hiramrodriguez14/Turbine_MCU/report.txt

Plotted to '/Users/hiramraul11gmail.com/Micro 2/TurbineMCUJST/gerbers/TurbineMCU-F_Cu.gtl'.
Plotted to '/Users/hiramraul11gmail.com/Micro 2/TurbineMCUJST/gerbers/TurbineMCU-In1_Cu.g1'.
Plotted to '/Users/hiramraul11gmail.com/Micro 2/TurbineMCUJST/gerbers/TurbineMCU-In2_Cu.g2'.
Plotted to '/Users/hiramraul11gmail.com/Micro 2/TurbineMCUJST/gerbers/TurbineMCU-B_Cu.gbl'.
Plotted to '/Users/hiramraul11gmail.com/Micro 2/TurbineMCUJST/gerbers/TurbineMCU-F_Paste.gtp'.
Plotted to '/Users/hiramraul11gmail.com/Micro 2/TurbineMCUJST/gerbers/TurbineMCU-B_Paste.gbp'.
Plotted to '/Users/hiramraul11gmail.com/Micro 2/TurbineMCUJST/gerbers/TurbineMCU-F_Silkscreen.gto'.
Plotted to '/Users/hiramraul11gmail.com/Micro 2/TurbineMCUJST/gerbers/TurbineMCU-B_Silkscreen.gbo'.
Plotted to '/Users/hiramraul11gmail.com/Micro 2/TurbineMCUJST/gerbers/TurbineMCU-F_Mask.gts'.
Plotted to '/Users/hiramraul11gmail.com/Micro 2/TurbineMCUJST/gerbers/TurbineMCU-B_Mask.gbs'.
Plotted to '/Users/hiramraul11gmail.com/Micro 2/TurbineMCUJST/gerbers/TurbineMCU-Edge_Cuts.gm1'.
Info: Done.
Info: Done.
