hiramrodriguez14/Turbine_MCU/mylib/DIP8.STEP

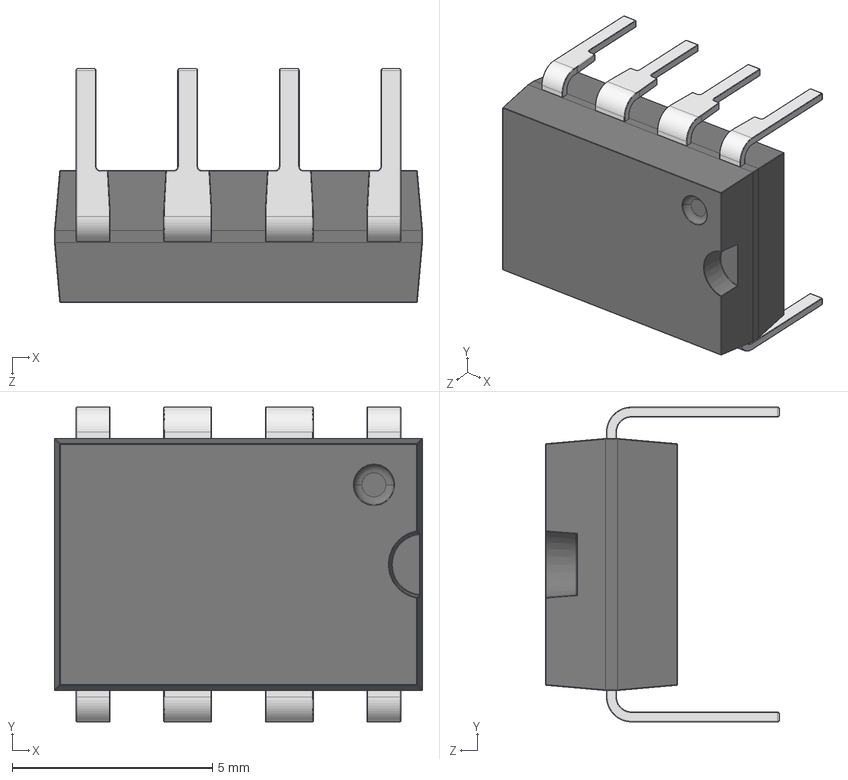
[picture p6: CAD file, 2026-04-30]
mylib/DIP8.STEP
9.20 x 7.87 x 5.85 mm
