hiramrodriguez14/Turbine_MCU/mylib/JST_3D/JST-XH7-SMD.step

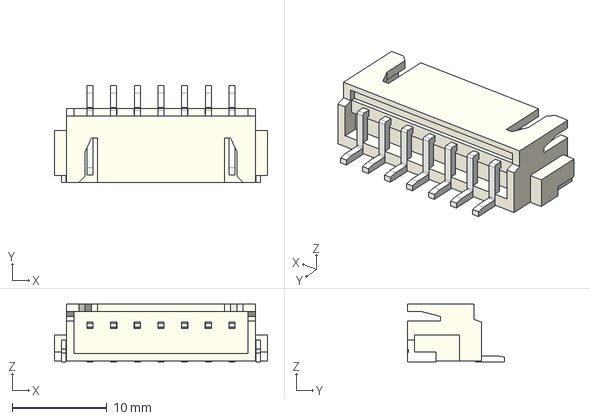
[picture p7: CAD file, 2026-04-30]
mylib/JST_3D/JST-XH7-SMD.step
22.5 x 10.2 x 6.10 mm
