hiramrodriguez14/Turbine_MCU/mylib/LIB_MCP41HV51-103E_ST/MCP41HV51-103E_ST/3D/MCP41HV51-103E_ST.stp

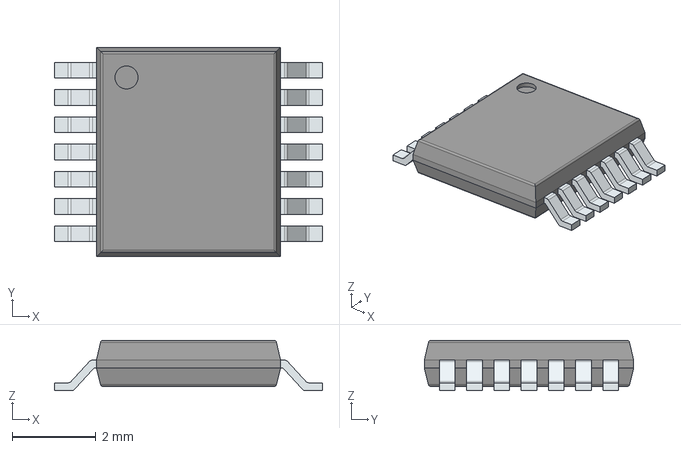
[picture p8: CAD file, 2026-04-30]
mylib/LIB_MCP41HV51-103E_ST/MCP41HV51-103E_ST/3D/MCP41HV51-103E_ST.stp
6.40 x 5.00 x 1.20 mm
PinsArrayLR
