hiramrodriguez14/Turbine_MCU/mylib/LIB_MSPM0G3507SPMR/MSPM0G3507SPMR/3D/MSPM0G3507SPMR.stp

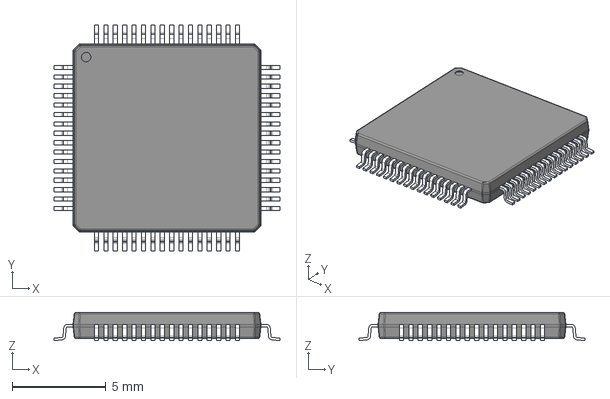
[picture p10: CAD file, 2026-04-30]
mylib/LIB_MSPM0G3507SPMR/MSPM0G3507SPMR/3D/MSPM0G3507SPMR.stp
12.0 x 12.0 x 1.50 mm
BODY-QFP
LEAD-QFP x 64
