hiramrodriguez14/Turbine_MCU/mylib/LIB_TC4429CPA/TC4429CPA/3D/TC4429CPA.stp

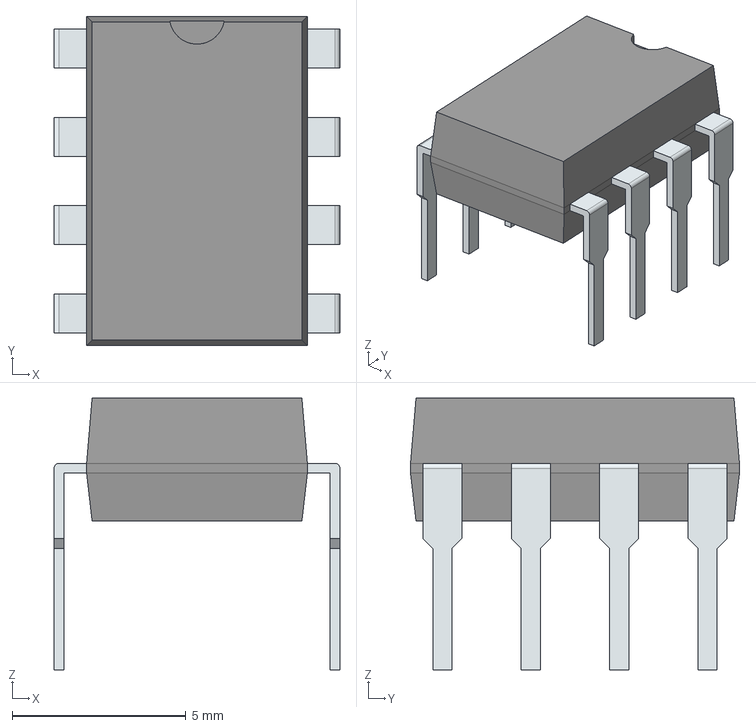
[picture p11: CAD file, 2026-04-30]
mylib/LIB_TC4429CPA/TC4429CPA/3D/TC4429CPA.stp
8.22 x 9.46 x 7.82 mm
PinsArrayLR
