hiramrodriguez14/Turbine_MCU/mylib/LIB_TPS2121RUXR/TPS2121RUXR/3D/TPS2121RUXR.stp

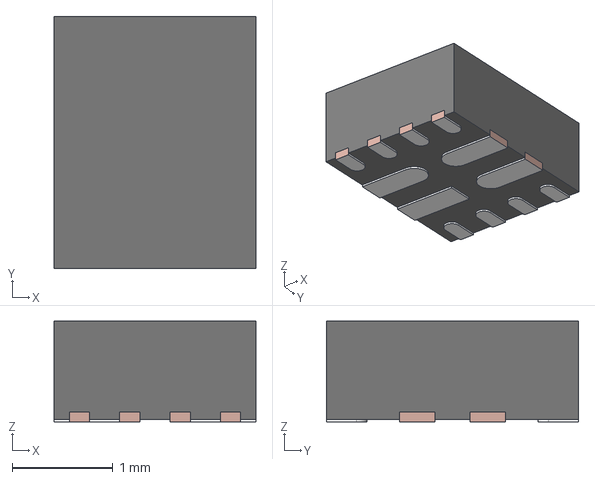
[picture p12: CAD file, 2026-04-30]
mylib/LIB_TPS2121RUXR/TPS2121RUXR/3D/TPS2121RUXR.stp
2.00 x 2.50 x 1.00 mm
FRAME
MOLD
