hiramrodriguez14/Turbine_MCU/mylib/JST_3D/JST-XH2-SMD.step

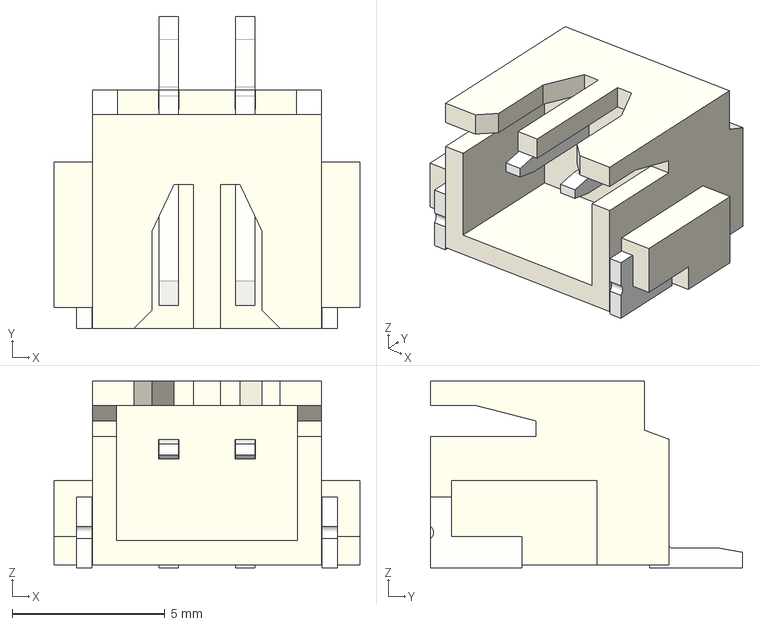
[picture p13: CAD file, 2026-04-30]
mylib/JST_3D/JST-XH2-SMD.step
10.0 x 10.2 x 6.10 mm
