hiramrodriguez14/Turbine_MCU/mylib/SW_Btn_XLX.step

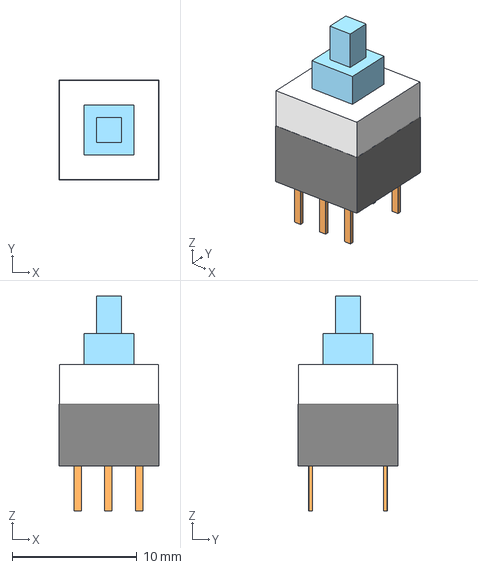
[picture p14: CAD file, 2026-04-30]
mylib/SW_Btn_XLX.step
8.00 x 8.00 x 17.2 mm
