hiramrodriguez14/Turbine_MCU/mylib/DIL14.stp

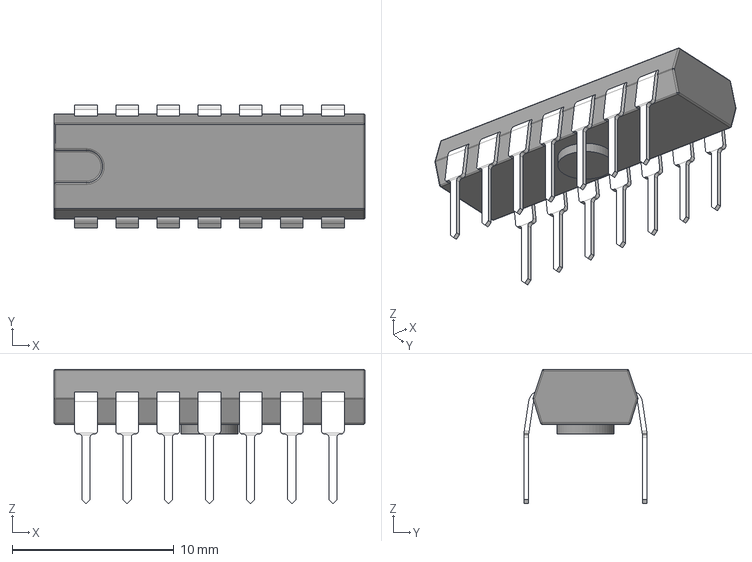
[picture p15: CAD file, 2026-04-30]
mylib/DIL14.stp
19.2 x 7.62 x 8.30 mm
DIP14_body
legs x 7
