hiramrodriguez14/Turbine_MCU/mylib/JST_3D/JST-XH6-SMD.step

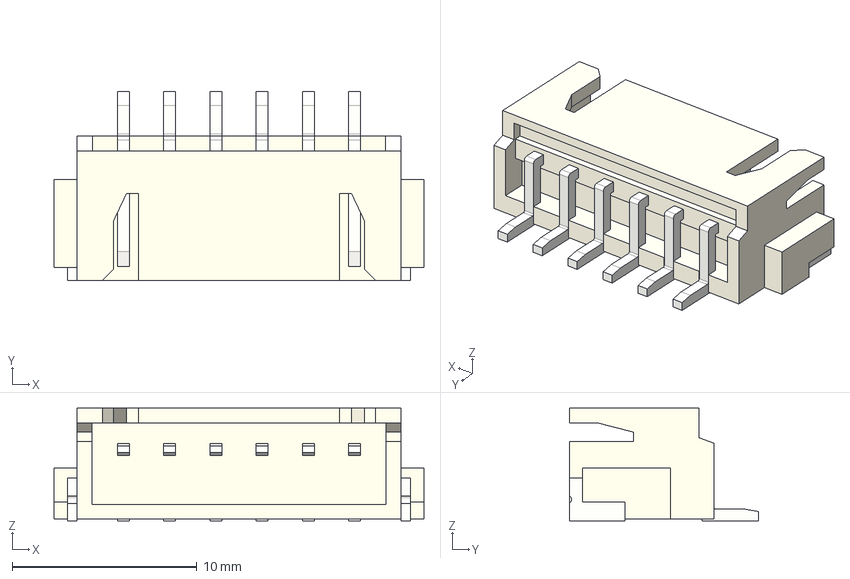
[picture p16: CAD file, 2026-04-30]
mylib/JST_3D/JST-XH6-SMD.step
20.0 x 10.2 x 6.10 mm
