hiramrodriguez14/Turbine_MCU/mylib/JST_3D/JST-XH5-SMD.step

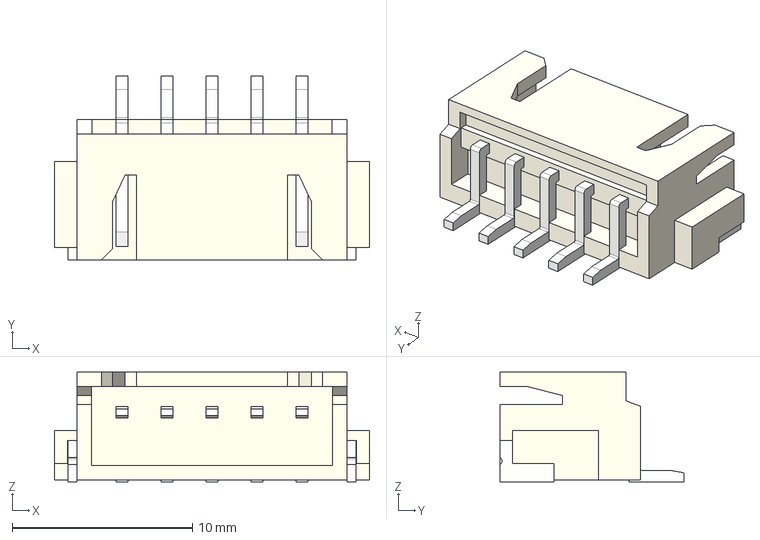
[picture p17: CAD file, 2026-04-30]
mylib/JST_3D/JST-XH5-SMD.step
17.5 x 10.2 x 6.10 mm
