hiramrodriguez14/Turbine_MCU/mylib/LQFP64 v1.step

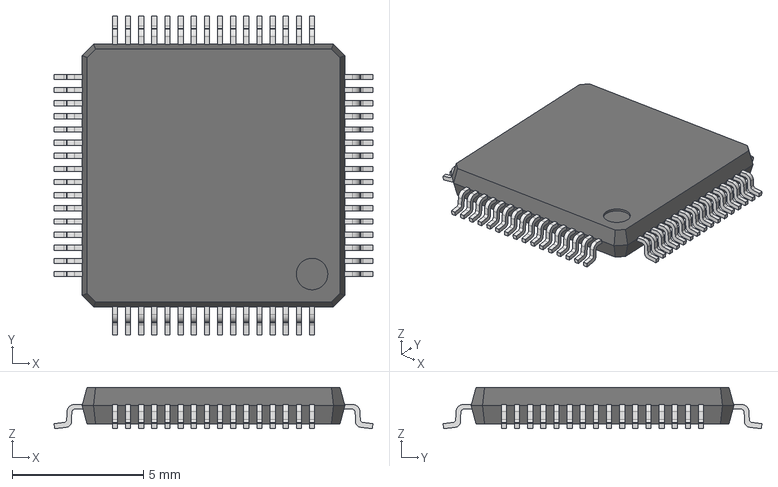
[picture p18: CAD file, 2026-04-30]
mylib/LQFP64 v1.step
12.1 x 12.1 x 1.58 mm
