hiramrodriguez14/Turbine_MCU/mylib/JST_3D/JST-XH3-SMD.step

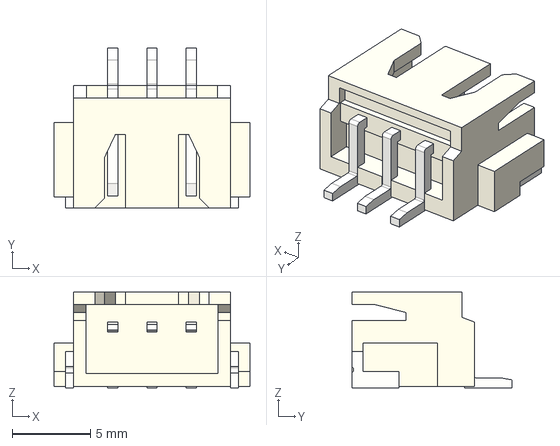
[picture p19: CAD file, 2026-04-30]
mylib/JST_3D/JST-XH3-SMD.step
12.5 x 10.2 x 6.10 mm
