hiramrodriguez14/Turbine_MCU/(list of files, cad)

Other CAD files:
mylib/LIB_MCP41HV51-103E_ST/MCP41HV51-103E_ST/Allegro/sop65p640x120-14n.psm
mylib/LIB_MCP41HV51-103E_ST/MCP41HV51-103E_ST/DEHDL/mcp41hv51_103e_st/chips/chips.prt
mylib/LIB_MCP45HV51-103E_ST/MCP45HV51-103E_ST/Allegro/sop65p640x120-14n.psm
mylib/LIB_MCP45HV51-103E_ST/MCP45HV51-103E_ST/DEHDL/mcp45hv51_103e_st/chips/chips.prt
mylib/LIB_MSPM0G3507SPMR/MSPM0G3507SPMR/Allegro/qfp50p1200x1200x160-64n.psm
mylib/LIB_MSPM0G3507SPMR/MSPM0G3507SPMR/DEHDL/mspm0g3507spmr/chips/chips.prt
mylib/LIB_TC4429CPA/TC4429CPA/Allegro/dip794w56p254l946h432q8n.psm
mylib/LIB_TC4429CPA/TC4429CPA/DEHDL/tc4429cpa/chips/chips.prt
mylib/LIB_TPS2121RUXR/TPS2121RUXR/Allegro/tps2121ruxr.psm
mylib/LIB_TPS2121RUXR/TPS2121RUXR/DEHDL/tps2121ruxr/chips/chips.prt
mylib/LIB_TPS61046YFFR/TPS61046YFFR/Allegro/bga6c40p2x3_88x123x62.psm
mylib/LIB_TPS61046YFFR/TPS61046YFFR/DEHDL/tps61046yffr/chips/chips.prt
mylib/LIB_TPS73533DRVT/TPS73533DRVT/3D/TPS73533DRVT.stp
mylib/LIB_TPS73533DRVT/TPS73533DRVT/Allegro/son65p200x200x80-7n.psm
mylib/LIB_TPS73533DRVT/TPS73533DRVT/DEHDL/tps73533drvt/chips/chips.prt
mylib/kf128-screw-terminal-2-54-mm-pitch-1.snapshot.2/KF128 2.54mm/KF128-2.54-10P.step
mylib/kf128-screw-terminal-2-54-mm-pitch-1.snapshot.2/KF128 2.54mm/KF128-2.54-11P.step
mylib/kf128-screw-terminal-2-54-mm-pitch-1.snapshot.2/KF128 2.54mm/KF128-2.54-12P.step
mylib/kf128-screw-terminal-2-54-mm-pitch-1.snapshot.2/KF128 2.54mm/KF128-2.54-2P.step
mylib/kf128-screw-terminal-2-54-mm-pitch-1.snapshot.2/KF128 2.54mm/KF128-2.54-3P.step
mylib/kf128-screw-terminal-2-54-mm-pitch-1.snapshot.2/KF128 2.54mm/KF128-2.54-4P.step
mylib/kf128-screw-terminal-2-54-mm-pitch-1.snapshot.2/KF128 2.54mm/KF128-2.54-5P.step
mylib/kf128-screw-terminal-2-54-mm-pitch-1.snapshot.2/KF128 2.54mm/KF128-2.54-6P.step
mylib/kf128-screw-terminal-2-54-mm-pitch-1.snapshot.2/KF128 2.54mm/KF128-2.54-7P.step
mylib/kf128-screw-terminal-2-54-mm-pitch-1.snapshot.2/KF128 2.54mm/KF128-2.54-8P.step
