hiramrodriguez14/Turbine_MCU/(list of files, drawings)

Other design files:
mylib/LIB_MCP41HV51-103E_ST/MCP41HV51-103E_ST/Altium/MCP41HV51-103E_ST.SchLib
mylib/LIB_MCP41HV51-103E_ST/MCP41HV51-103E_ST/Altium/SOP65P640X120-14N.PcbLib
mylib/LIB_MCP45HV51-103E_ST/MCP45HV51-103E_ST/Altium/MCP45HV51-103E_ST.SchLib
mylib/LIB_MCP45HV51-103E_ST/MCP45HV51-103E_ST/Altium/SOP65P640X120-14N.PcbLib
mylib/LIB_MSPM0G3507SPMR/MSPM0G3507SPMR/Altium/MSPM0G3507SPMR.SchLib
mylib/LIB_MSPM0G3507SPMR/MSPM0G3507SPMR/Altium/QFP50P1200X1200X160-64N.PcbLib
mylib/LIB_TC4429CPA/TC4429CPA/Altium/DIP794W56P254L946H432Q8N.PcbLib
mylib/LIB_TC4429CPA/TC4429CPA/Altium/TC4429CPA.SchLib
mylib/LIB_TPS2121RUXR/TPS2121RUXR/Altium/TPS2121RUXR.PcbLib
mylib/LIB_TPS2121RUXR/TPS2121RUXR/Altium/TPS2121RUXR.SchLib
mylib/LIB_TPS73533DRVT/TPS73533DRVT/Altium/SON65P200X200X80-7N.PcbLib
mylib/LIB_TPS73533DRVT/TPS73533DRVT/Altium/TPS73533DRVT.SchLib
