hiramrodriguez14/Turbine_MCU/TurbineMCU.kicad_pcb

## KiCad design TurbineMCU.kicad_pcb (2026-06-20)

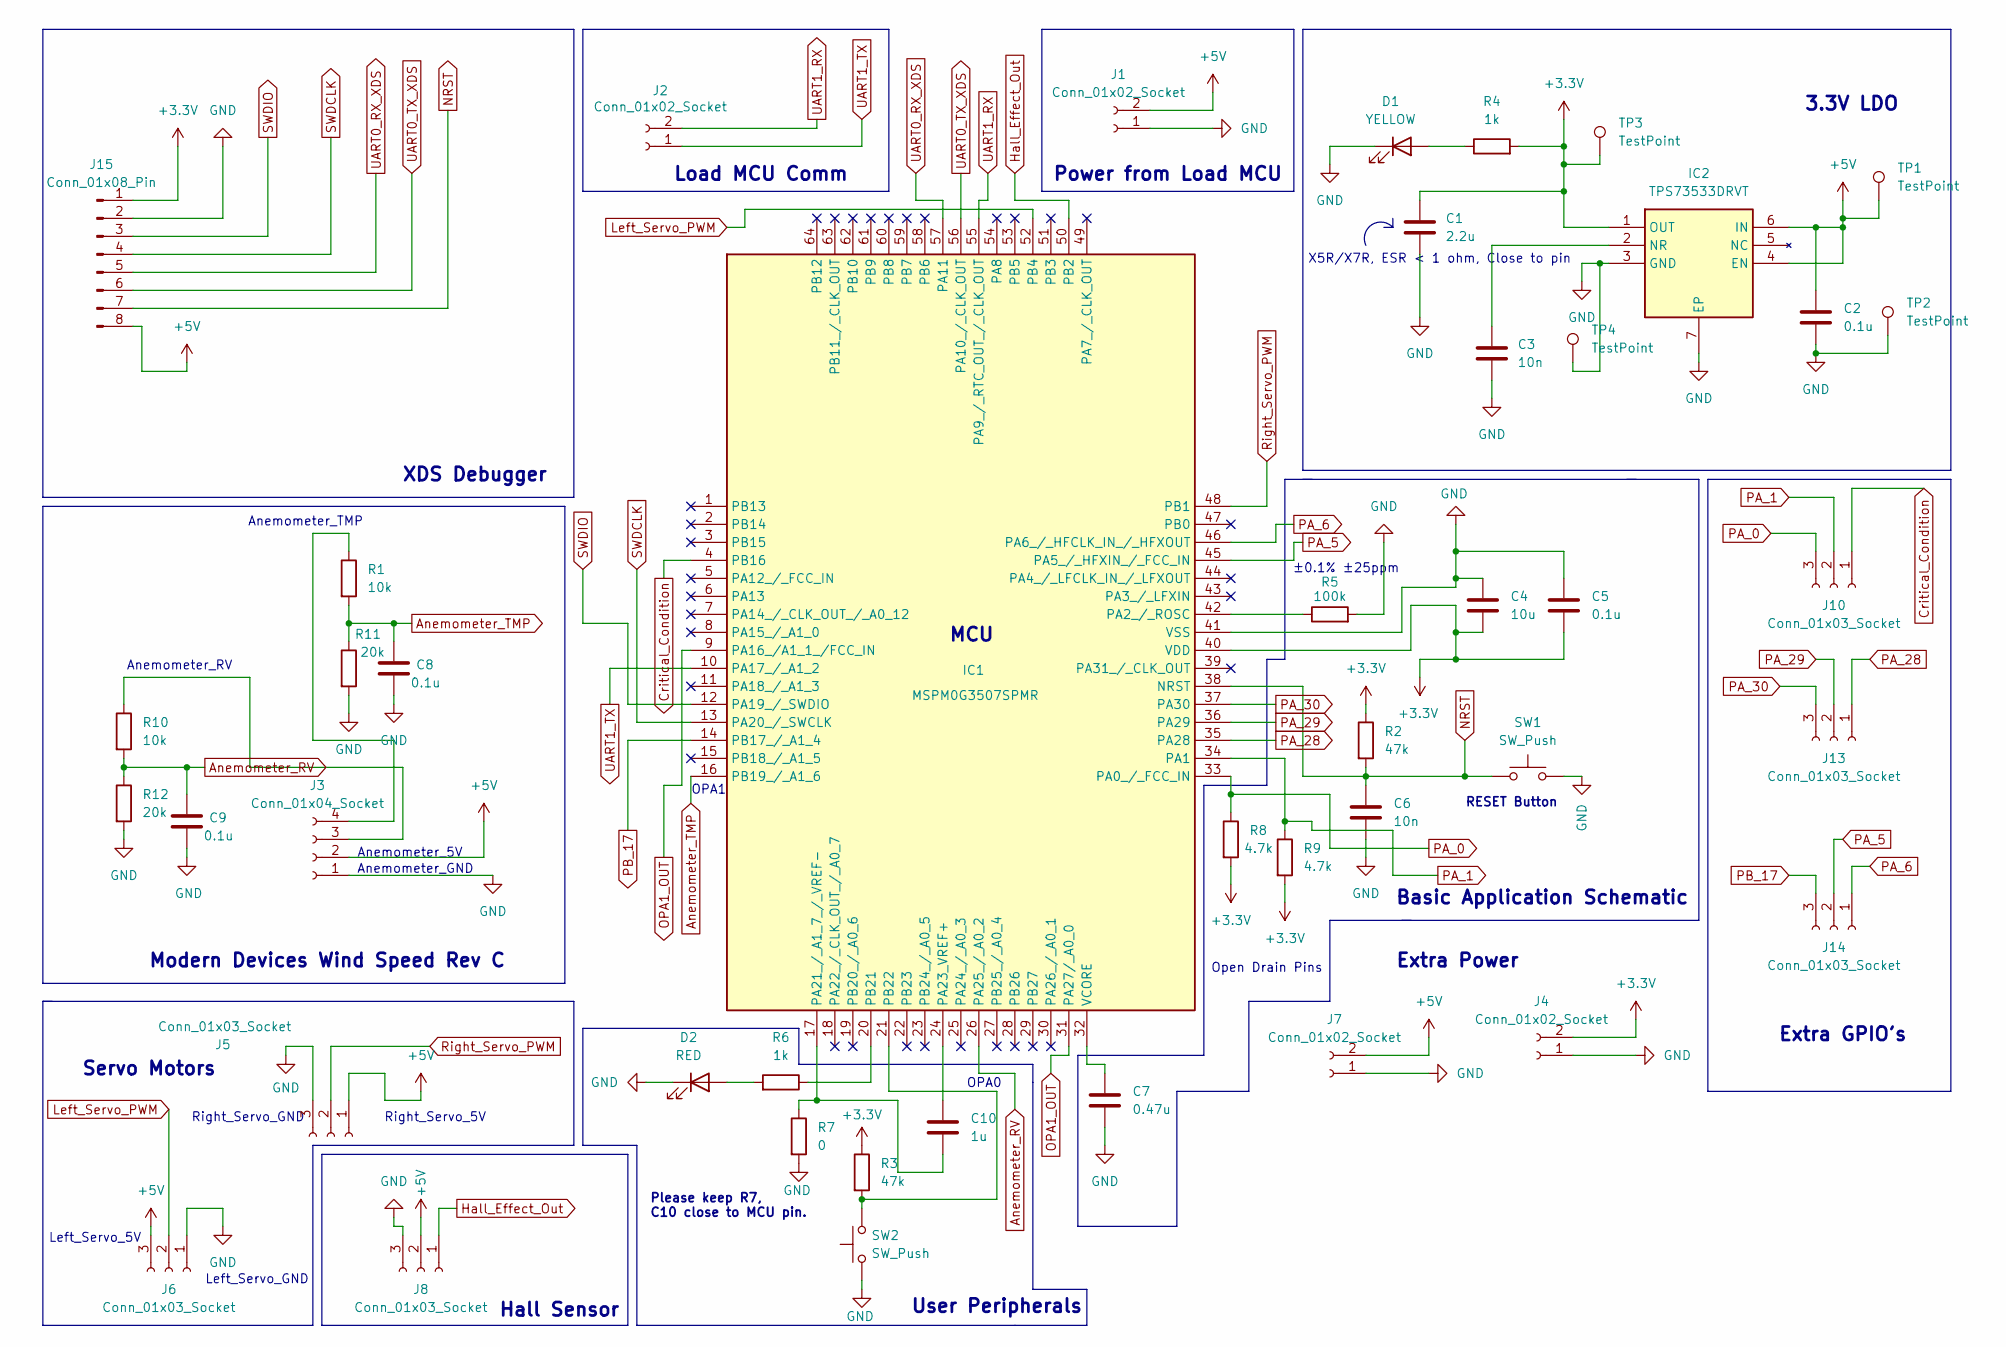
[picture p24: schematic TurbineMCU.kicad_sch, Turbine MCU]

Parts:
C1: 2.2u; C_1206_3216Metric_Pad1.33x1.80mm_HandSolder
C2, C5, C8, C9: 0.1u; C_0805_2012Metric_Pad1.18x1.45mm_HandSolder
C3: 10n; C_0402_1005Metric_Pad0.74x0.62mm_HandSolder
C4: 10u; C_1206_3216Metric_Pad1.33x1.80mm_HandSolder
C6: 10n; C_1206_3216Metric_Pad1.33x1.80mm_HandSolder
C7: 0.47u; C_0805_2012Metric_Pad1.18x1.45mm_HandSolder
C10: 1u; C_0402_1005Metric_Pad0.74x0.62mm_HandSolder
D1: YELLOW; LED_0805_2012Metric_Pad1.15x1.40mm_HandSolder
D2: RED; LED_0603_1608Metric_Pad1.05x0.95mm_HandSolder
IC1: MSPM0G3507SPMR; QFP50P1200X1200X160-64N; Mouser Part Number 595-MSPM0G3507SPMR
IC2: TPS73533DRVT; SON65P200X200X80-7N; Mouser Part Number 595-TPS73533DRVT
J1, J2, J4, J7: Conn_01x02_Socket; TerminalBlock_Xinya_XY308-2.54-2P_1x02_P2.54mm_Horizontal
J3: Conn_01x04_Socket; JST_XH_B4B-XH-A_1x04_P2.50mm_Vertical
J5, J6, J8: Conn_01x03_Socket; JST_XH_B3B-XH-A_1x03_P2.50mm_Vertical
J10, J13, J14: Conn_01x03_Socket; TerminalBlock_Xinya_XY308-2.54-3P_1x03_P2.54mm_Horizontal
J15: Conn_01x08_Pin; PinHeader_1x08_P2.54mm_Vertical
R1, R10: 10k; R_1206_3216Metric_Pad1.30x1.75mm_HandSolder
R2, R3: 47k; R_0805_2012Metric_Pad1.20x1.40mm_HandSolder
R4: 1k; R_0805_2012Metric_Pad1.20x1.40mm_HandSolder
R5: 100k; R_0603_1608Metric_Pad0.98x0.95mm_HandSolder
R6: 1k; R_1206_3216Metric_Pad1.30x1.75mm_HandSolder
R7: 0; R_0402_1005Metric_Pad0.72x0.64mm_HandSolder
R8, R9: 4.7k; R_0805_2012Metric_Pad1.20x1.40mm_HandSolder
R11, R12: 20k; R_1206_3216Metric_Pad1.30x1.75mm_HandSolder
SW1, SW2: SW_Push; SW_PUSH_6mm
TP1, TP2, TP3, TP4: TestPoint; TestPoint_Pad_D1.0mm

Connections:
+3.3V: C1.1, C4.2, C5.2, IC1.40 (VDD), IC2.1 (OUT), J4.2, J15.1, R2.1, R3.1, R4.2, R8.2, R9.2, TP3.1
+5V: C2.1, IC2.4 (EN), IC2.6 (IN), J1.2, J3.2, J5.1, J6.3, J7.2, J8.2, J15.8, TP1.1
Anemometer_RV: C9.1, IC1.26 (PA25_/_A0_2), R10.2, R12.1
Anemometer_TMP: C8.1, IC1.16 (PB19_/_A1_6), R1.2, R11.1
Critical_Condition: IC1.4 (PB16), J10.1
GND: C1.2, C2.2, C3.2, C4.1, C5.1, C6.2, C7.2, C8.2, C9.2, D1.1 (K), D2.1 (K), IC1.41 (VSS), IC2.3 (GND), IC2.7 (EP), J1.1, J3.1, J4.1, J5.3, J6.1, J7.1, J8.3, J15.2, R5.2, R7.2, R11.2, R12.2, SW1.2, SW2.1, TP2.1, TP4.1
Hall_Effect_Out: IC1.50 (PB2), J8.1
Left_Servo_PWM: IC1.52 (PB4), J6.2
NRST: C6.1, IC1.38 (NRST), J15.7, R2.2, SW1.1
unnamed: D1.2 (A), R4.1
unnamed: D2.2 (A), R6.2
unnamed: IC1.42 (PA2_/_ROSC), R5.1
unnamed: C10.2, IC1.17 (PA21_/_A1_7_/_VREF-), R7.1
unnamed: C10.1, IC1.24 (PA23_VREF+)
unnamed: IC1.20 (PB21), R6.1
unnamed: IC1.21 (PB22), R3.2, SW2.2
unnamed: C7.1, IC1.32 (VCORE)
unnamed: C3.1, IC2.2 (NR)
unnamed: J3.3, R10.1
unnamed: J3.4, R1.1
OPA1_OUT: IC1.9 (PA16_/A1_1_/FCC_IN), IC1.31 (PA27/_A0_0)
PA_0: IC1.33 (PA0_/_FCC_IN), J10.3, R8.1
PA_1: IC1.34 (PA1), J10.2, R9.1
PA_5: IC1.45 (PA5_/_HFXIN_/_FCC_IN), J14.2
PA_6: IC1.46 (PA6_/_HFCLK_IN_/_HFXOUT), J14.1
PA_28: IC1.35 (PA28), J13.1
PA_29: IC1.36 (PA29), J13.2
PA_30: IC1.37 (PA30), J13.3
PB_17: IC1.14 (PB17_/_A1_4), J14.3
Right_Servo_PWM: IC1.48 (PB1), J5.2
SWDCLK: IC1.13 (PA20_/_SWCLK), J15.4
SWDIO: IC1.12 (PA19_/_SWDIO), J15.3
UART0_RX_XDS: IC1.57 (PA11), J15.5
UART0_TX_XDS: IC1.56 (PA10_/_CLK_OUT), J15.6
UART1_RX: IC1.55 (PA9_/_RTC_OUT_/_CLK_OUT), J2.2
UART1_TX: IC1.10 (PA17_/_A1_2), J2.1

Notes on the sheet:
User Peripherals
Hall Sensor
Basic Application Schematic
OPA0
Left_Servo_GND
Left_Servo_5V
Anemometer_5V
Please keep R7, C10 close to MCU pin.
Load MCU Comm
OPA1
Right_Servo_5V
RESET Button
Anemometer_TMP
X5R/X7R, ESR < 1 ohm, Close to pin
Open Drain Pins
3.3V LDO
Right_Servo_GND
Extra GPIO's
±0.1% ±25ppm
Modern Devices Wind Speed Rev C
Extra Power
Servo Motors
Anemometer_RV
XDS Debugger
MCU
Anemometer_GND
Power from Load MCU

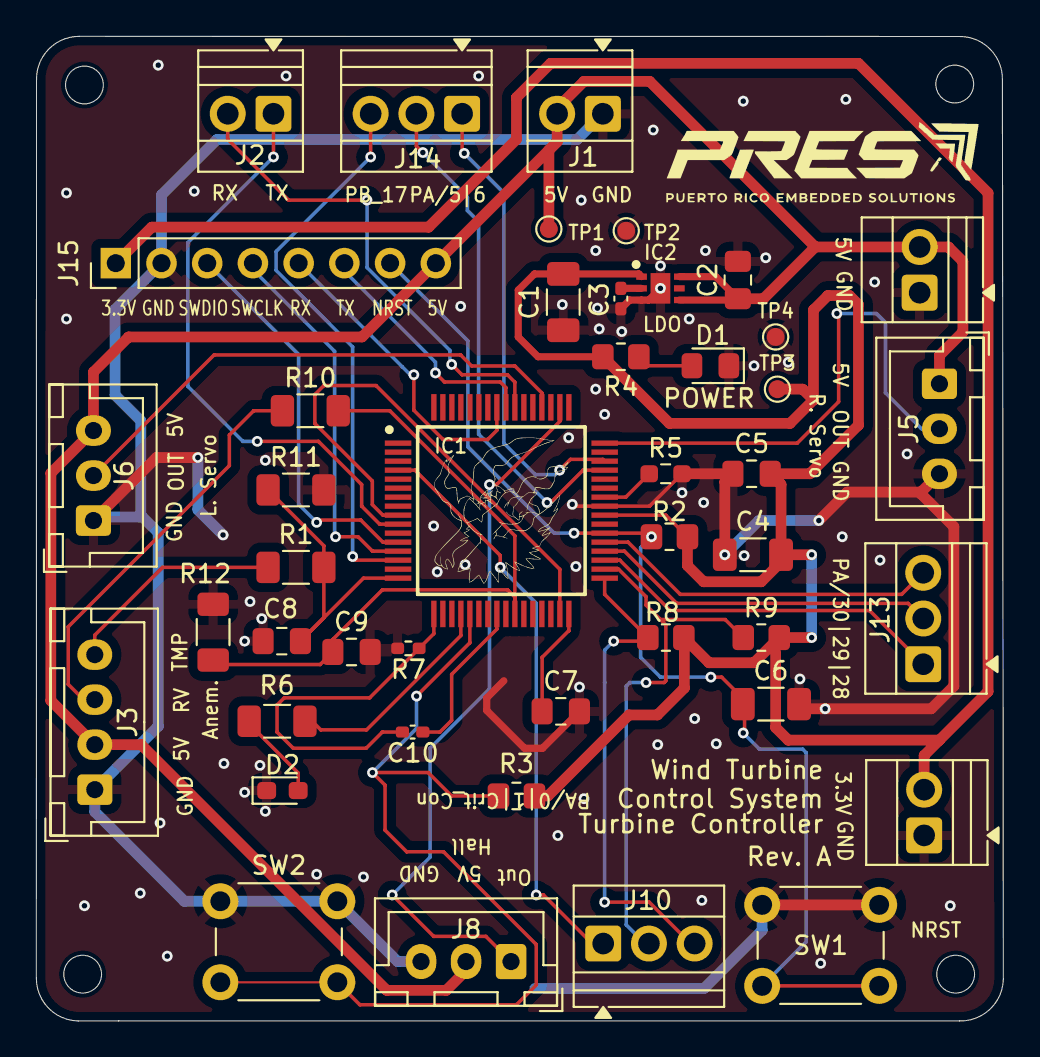
[picture p25: board TurbineMCU.kicad_pcb from above]

Board: 2 copper layers, 53.7 x 54.7 mm, 44 parts (0 on the bottom side), 36 nets.
