hiramrodriguez14/Turbine_MCU/(commit log)

2026-04-30 Initial KiCad project commit
    [DIL14.stp, DIP794W56P254L946H432Q8N.PcbLib, DIP8.STEP, EDI2CAP.CFG, JST-XH2-SMD.step, JST-XH3-SMD.step, JST-XH4-SMD.step, JST-XH5-SMD.step]
2026-04-30 Fixed library and step model path
    [TurbineMCU.kicad_pcb]
2026-04-30 Fixed IC2 silkscreen
    [TurbineMCU.kicad_pcb]
2026-05-01 Improved LDO layout based on manufacturer guidelines
    [TurbineMCU.kicad_pcb, TurbineMCU.kicad_sch]
2026-05-01 pick and place file added
    [TurbineMCU-all-pos.csv]
2026-05-01 final layout
    [TurbineMCU-B_Cu.gbl, TurbineMCU-B_Mask.gbs, TurbineMCU-B_Paste.gbp, TurbineMCU-B_Silkscreen.gbo, TurbineMCU-Edge_Cuts.gm1, TurbineMCU-F_Cu.gtl, TurbineMCU-F_Mask.gts, TurbineMCU-F_Paste.gtp]
2026-05-01 board finished
    [TurbineMCU.kicad_pcb]
2026-05-05 Added testpoints
    [TurbineMCU.kicad_pcb, TurbineMCU.kicad_sch]
2026-05-20 ready for manufacturing
    [TurbineMCU-B_Cu.gbl, TurbineMCU-B_Mask.gbs, TurbineMCU-B_Paste.gbp, TurbineMCU-B_Silkscreen.gbo, TurbineMCU-Edge_Cuts.gm1, TurbineMCU-F_Cu.gtl, TurbineMCU-F_Mask.gts, TurbineMCU-F_Paste.gtp]
2026-05-21 This commit contains all files up dotae to Rev A. Turbine MCU, manufactured on May 21, 2026
    [TurbineMCU-B_Cu.gbl, TurbineMCU-B_Mask.gbs, TurbineMCU-B_Paste.gbp, TurbineMCU-B_Silkscreen.gbo, TurbineMCU-Edge_Cuts.gm1, TurbineMCU-F_Cu.gtl, TurbineMCU-F_Mask.gts, TurbineMCU-F_Paste.gtp]
2026-06-20 Fixed silks screen
    [TurbineMCU-B_Mask.gbs, TurbineMCU-B_Paste.gbp, TurbineMCU-B_SilkS.gbo, TurbineMCU-Back.gbl, TurbineMCU-Edge_Cuts.gm1, TurbineMCU-F_Mask.gts, TurbineMCU-F_Paste.gtp, TurbineMCU-F_SilkS.gto]
